aryaan-hegde/PulseOS/README.md

# PulseOS
A smartwatch that can detect, monitor and display your heart rate. Controlled with a custom RP2350-based PCB
