aryaan-hegde/PulseOS/f5d17f86-9e19-4940-80e7-bea705c3136f.png

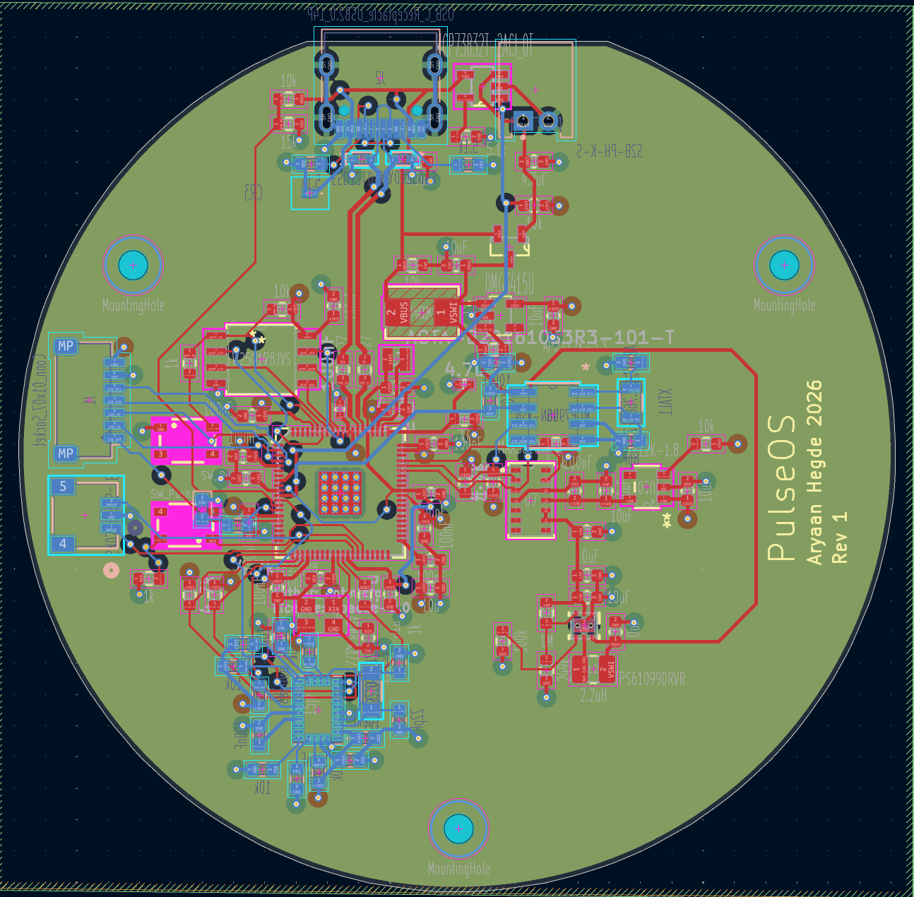
f5d17f86-9e19-4940-80e7-bea705c3136f.png
