aryaan-hegde/PulseOS/PCB/pulse_os/pulse_os.csv

Reference | Qty | Value | DNP | Exclude from BOM | Exclude from Board | Exclude from Simulation | Exclude from Position Files | Footprint | Datasheet
C1,C2,C31,C34,C35,C36,C37,C38 | 8 | 10uF |  |  |  |  | ${EXCLUDE_FROM_POS_FILES} | Capacitor_SMD:C_0603_1608Metric
C3,C6,C27,C28,C29 | 5 | 100nF |  |  |  |  | ${EXCLUDE_FROM_POS_FILES} | Capacitor_SMD:C_0603_1608Metric
C4,C5 | 2 | 8pF |  |  |  |  | ${EXCLUDE_FROM_POS_FILES} | Capacitor_SMD:C_0603_1608Metric
C7,C26 | 2 | 22pF |  |  |  |  | ${EXCLUDE_FROM_POS_FILES} | Capacitor_SMD:C_0603_1608Metric
C8,C11,C13,C14,C15,C16,C17,C18,C19,C20,C21 | 11 | 100n |  |  |  |  | ${EXCLUDE_FROM_POS_FILES} | Capacitor_SMD:C_0603_1608Metric
C9,C10,C12,C22 | 4 | 4.7u |  |  |  |  | ${EXCLUDE_FROM_POS_FILES} | Capacitor_SMD:C_0603_1608Metric
C23 | 1 | 10u |  |  |  |  | ${EXCLUDE_FROM_POS_FILES} | Capacitor_SMD:C_0603_1608Metric
C24,C25 | 2 | 15pF |  |  |  |  | ${EXCLUDE_FROM_POS_FILES} | Capacitor_SMD:C_0603_1608Metric
C30 | 1 | ABS07-32.768KHZ-T |  |  |  |  | ${EXCLUDE_FROM_POS_FILES} | PulseOS Footprints:CAP_ABS07-32.768KHZ-T_ABR | ABS07-32.768KHZ-T
C32,C33 | 2 | 4.7uF |  |  |  |  | ${EXCLUDE_FROM_POS_FILES} | Capacitor_SMD:C_0603_1608Metric
C39 | 1 | 0.1uF |  |  |  |  | ${EXCLUDE_FROM_POS_FILES} | Capacitor_SMD:C_0603_1608Metric
CR1,CR2 | 2 | ESD321DYAR |  |  |  |  | ${EXCLUDE_FROM_POS_FILES} | PulseOS Footprints:SOT5x3_DYA_TEX | https://www.ti.com/lit/gpn/esd321
CR3 | 1 | ESD441DPLR |  |  |  |  | ${EXCLUDE_FROM_POS_FILES} | PulseOS Footprints:X2SON2_DPL_TEX | https://www.ti.com/lit/gpn/esd441
D1 | 1 | CDBW140-G |  |  |  |  | ${EXCLUDE_FROM_POS_FILES} | PulseOS Footprints:CDBB-G
D2 | 1 | LED |  |  |  |  | ${EXCLUDE_FROM_POS_FILES} | LED_SMD:LED_0201_0603Metric
J1 | 1 | Conn_01x07_Socket |  |  |  |  | ${EXCLUDE_FROM_POS_FILES} | Connector_JST:JST_SH_SM07B-SRSS-TB_1x07-1MP_P1.00mm_Horizontal
J2 | 1 | USB_C_Receptacle_USB2.0_14P |  |  |  |  | ${EXCLUDE_FROM_POS_FILES} | Connector_USB:USB_C_Receptacle_HRO_TYPE-C-31-M-12 | https://www.usb.org/sites/default/files/documents/usb_type-c.zip
J3 | 1 | S2B-PH-K-S |  |  |  |  | ${EXCLUDE_FROM_POS_FILES} | PulseOS Footprints:JST_S2B-PH-K-S
J4 | 1 | SM03B-SRSS-TB |  |  |  |  | ${EXCLUDE_FROM_POS_FILES} | PulseOS Footprints:CONN_SM03B-SRSS-TB_JST | SM03B-SRSS-TB
L2 | 1 | 2.2uH |  |  |  |  | ${EXCLUDE_FROM_POS_FILES} | Inductor_SMD:L_1008_2520Metric
L3 | 1 | AOTA-B201610S3R3-101-T |  |  |  |  | ${EXCLUDE_FROM_POS_FILES} | PulseOS Footprints:IND_AOTA-B201610S_2p0x1p6x1p0_ABR | AOTA-B201610S3R3-101-T
Q1 | 1 | DMG3415U |  |  |  |  | ${EXCLUDE_FROM_POS_FILES} | PulseOS Footprints:DMG3415U | https://ngspice.sourceforge.io/docs/ngspice-html-manual/manual.xhtml#cha_MOSFETs
R1,R2,R20 | 3 | 5.1k |  |  |  |  | ${EXCLUDE_FROM_POS_FILES} | Resistor_SMD:R_0603_1608Metric
R5 | 1 | 33 |  |  |  |  | ${EXCLUDE_FROM_POS_FILES} | Resistor_SMD:R_0603_1608Metric
R6,R7,R8,R16,R21,R22,R29,R31,R32,R33,R34,R35,R36,R37,R39 | 15 | 10k |  |  |  |  | ${EXCLUDE_FROM_POS_FILES} | Resistor_SMD:R_0603_1608Metric
R9,R10,R11,R40 | 4 | 1k |  |  |  |  | ${EXCLUDE_FROM_POS_FILES} | Resistor_SMD:R_0603_1608Metric
R17,R25 | 2 | 27 |  |  |  |  | ${EXCLUDE_FROM_POS_FILES} | Resistor_SMD:R_0603_1608Metric
R18,R19,R27,R28,R38 | 5 | 4.7k |  |  |  |  | ${EXCLUDE_FROM_POS_FILES} | Resistor_SMD:R_0603_1608Metric
R23 | 1 | 1M |  |  |  |  | ${EXCLUDE_FROM_POS_FILES} | Resistor_SMD:R_0603_1608Metric
R24 | 1 | 249k |  |  |  |  | ${EXCLUDE_FROM_POS_FILES} | Resistor_SMD:R_0603_1608Metric
R26 | 1 | 100k |  |  |  |  | ${EXCLUDE_FROM_POS_FILES} | Resistor_SMD:R_0603_1608Metric
R30 | 1 | 15k |  |  |  |  | ${EXCLUDE_FROM_POS_FILES} | Resistor_SMD:R_0603_1608Metric
SW1,SW2 | 2 | SW_Push |  |  |  |  | ${EXCLUDE_FROM_POS_FILES} | PulseOS Footprints:434133025816
U1 | 1 | RP2350B |  |  |  |  | ${EXCLUDE_FROM_POS_FILES} | PulseOS Footprints:QFN-80_EP_10x10_Pitch0.4mm | https://datasheets.raspberrypi.com/rp2350/rp2350-datasheet.pdf
U2 | 1 | AP2112K-3.3 |  |  |  |  | ${EXCLUDE_FROM_POS_FILES} | PulseOS Footprints:AP2112K_3_3 | https://www.diodes.com/assets/Datasheets/AP2112.pdf
U4 | 1 | W25Q128JVS |  |  |  |  | ${EXCLUDE_FROM_POS_FILES} | PulseOS Footprints:SOIC_128JVSIQ_WIN | https://www.winbond.com/resource-files/w25q128jv_dtr%20revc%2003272018%20plus.pdf
U5 | 1 | BNO085 |  |  |  |  | ${EXCLUDE_FROM_POS_FILES} | PulseOS Footprints:IC_BNO085
U6 | 1 | MCP7940N-xSN |  |  |  |  | ${EXCLUDE_FROM_POS_FILES} | PulseOS Footprints:SOIC8-N_MC_MCH | http://ww1.microchip.com/downloads/en/DeviceDoc/20005010F.pdf
U7 | 1 | MAX30101EFD+ |  |  |  |  | ${EXCLUDE_FROM_POS_FILES} | PulseOS Footprints:MAX30101 | MAX30101EFD+
U8 | 1 | TPS61099DRVR |  |  |  |  | ${EXCLUDE_FROM_POS_FILES} | PulseOS Footprints:DRV0006A | https://www.ti.com/lit/gpn/tps61099
U9 | 1 | MCP73832T-2ACI_OT |  |  |  |  | ${EXCLUDE_FROM_POS_FILES} | PulseOS Footprints:MCP73832T
U10 | 1 | AP2112K-1.8 |  |  |  |  | ${EXCLUDE_FROM_POS_FILES} | PulseOS Footprints:AP2112K-1.8TRG1_DIO | https://www.diodes.com/assets/Datasheets/AP2112.pdf
X1 | 1 | ABM8-272-T3 |  |  |  |  | ${EXCLUDE_FROM_POS_FILES} | PulseOS Footprints:ABM8-272-T3_ABR | ABM8-272-T3
XTAL1 | 1 | ABS07-32.768KHZ-7-T |  |  |  |  | ${EXCLUDE_FROM_POS_FILES} | PulseOS Footprints:XTAL_ABS07-32.768KHZ-7-T_ABR | ABS07-32.768KHZ-7-T
