aryaan-hegde/PulseOS/3D_files/assembly.stl

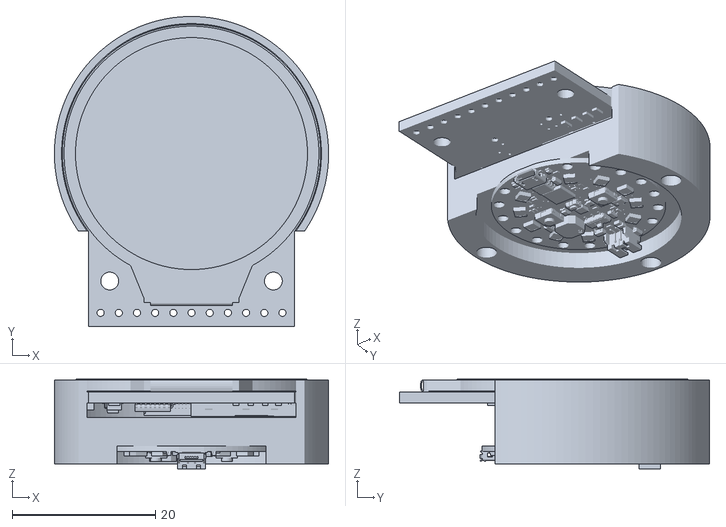
[picture p16: CAD file, 2026-10-20]
3D_files/assembly.stl
38.3 x 43.3 x 12.5
