aryaan-hegde/PulseOS/PCB/pulse_os/3d_models/SOIC8-N_MC_MCH.step

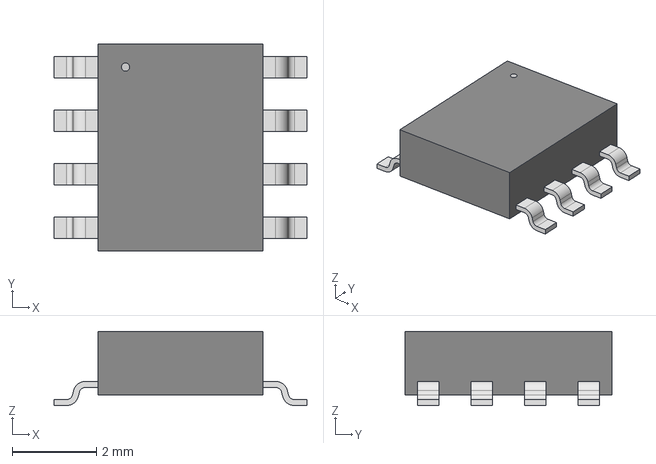
[picture p17: CAD file, 2026-11-12]
PCB/pulse_os/3d_models/SOIC8-N_MC_MCH.step
5.99 x 4.90 x 1.75 mm
