aryaan-hegde/PulseOS/PCB/pulse_os/3d_models/ESD441DPYR.stp

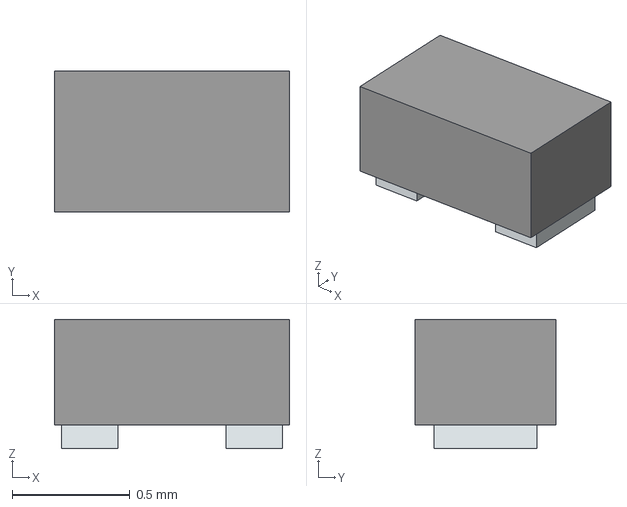
[picture p18: CAD file, 2026-11-12]
PCB/pulse_os/3d_models/ESD441DPYR.stp
1.00 x 0.6 x 0.55 mm
Pins
