aryaan-hegde/PulseOS/PCB/pulse_os/3d_models/ABM8-272-T3_ABR.step

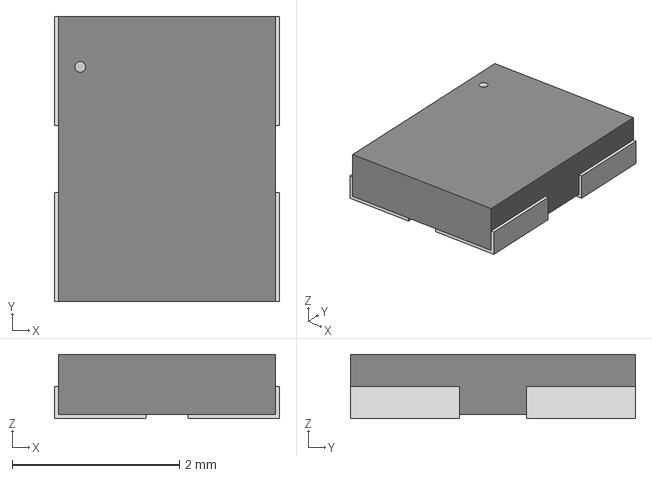
[picture p19: CAD file, 2026-11-12]
PCB/pulse_os/3d_models/ABM8-272-T3_ABR.step
2.69 x 3.40 x 0.765 mm
