aryaan-hegde/PulseOS/PCB/pulse_os/3d_models/SOT-23-5_MC_MCH.step

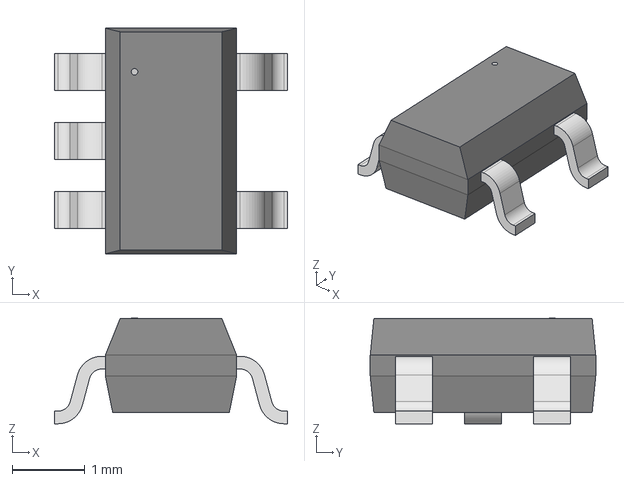
[picture p20: CAD file, 2026-11-12]
PCB/pulse_os/3d_models/SOT-23-5_MC_MCH.step
3.20 x 3.10 x 1.45 mm
