aryaan-hegde/PulseOS/PCB/pulse_os/3d_models/IND_AOTA-B201610S_2p0x1p6x1p0_ABR.stl

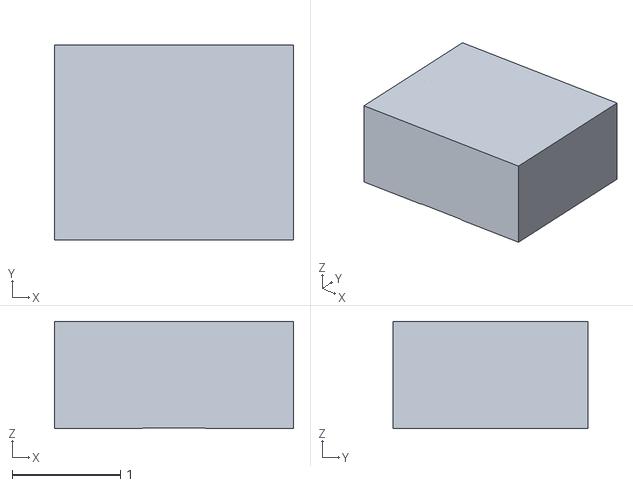
[picture p21: CAD file, 2026-11-12]
PCB/pulse_os/3d_models/IND_AOTA-B201610S_2p0x1p6x1p0_ABR.stl
2.21 x 1.80 x 0.993
