aryaan-hegde/PulseOS/PCB/pulse_os/3d_models/XTAL_ABS07-32_768KHZ-7-T_ABR.stl

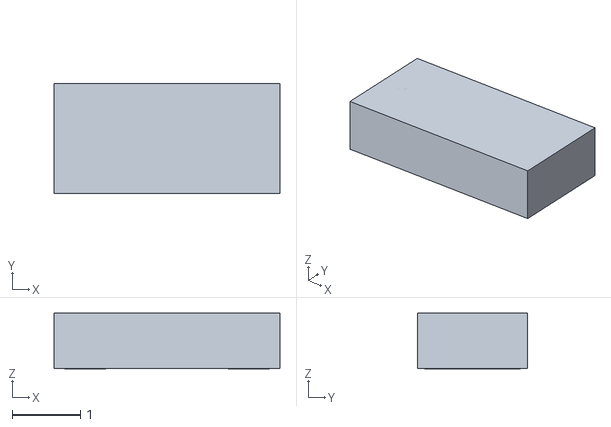
[picture p22: CAD file, 2026-11-12]
PCB/pulse_os/3d_models/XTAL_ABS07-32_768KHZ-7-T_ABR.stl
3.30 x 1.60 x 0.815
