aryaan-hegde/PulseOS/PCB/pulse_os/3d_models/SOIC_128JVSIQ_WIN.stl

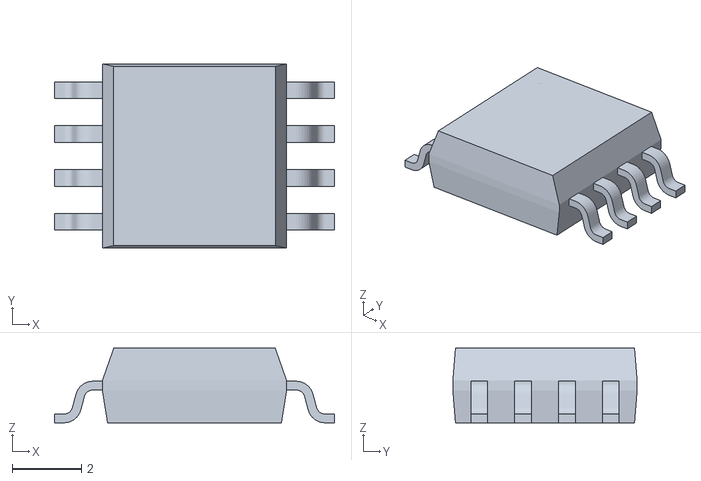
[picture p23: CAD file, 2026-11-12]
PCB/pulse_os/3d_models/SOIC_128JVSIQ_WIN.stl
8.10 x 5.33 x 2.16
