aryaan-hegde/PulseOS/PCB/pulse_os/3d_models/TPS61099DRVR.STEP

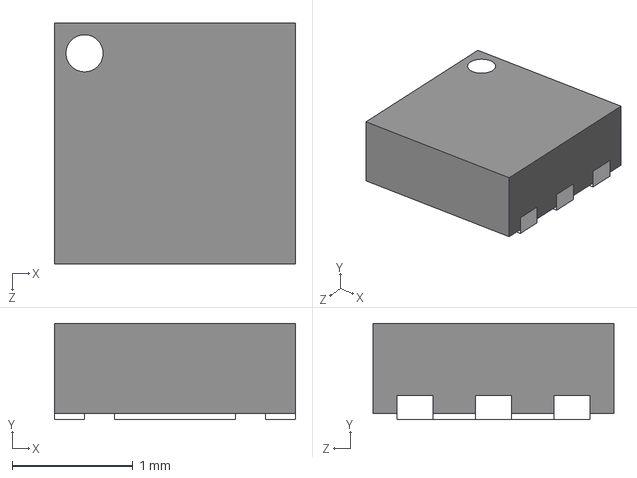
[picture p24: CAD file, 2026-11-12]
PCB/pulse_os/3d_models/TPS61099DRVR.STEP
2.00 x 0.8 x 2.00 mm
