aryaan-hegde/PulseOS/PCB/pulse_os/pulse_os.kicad_pcb

## KiCad design PCB/pulse_os/pulse_os.kicad_pcb (2026-11-12)

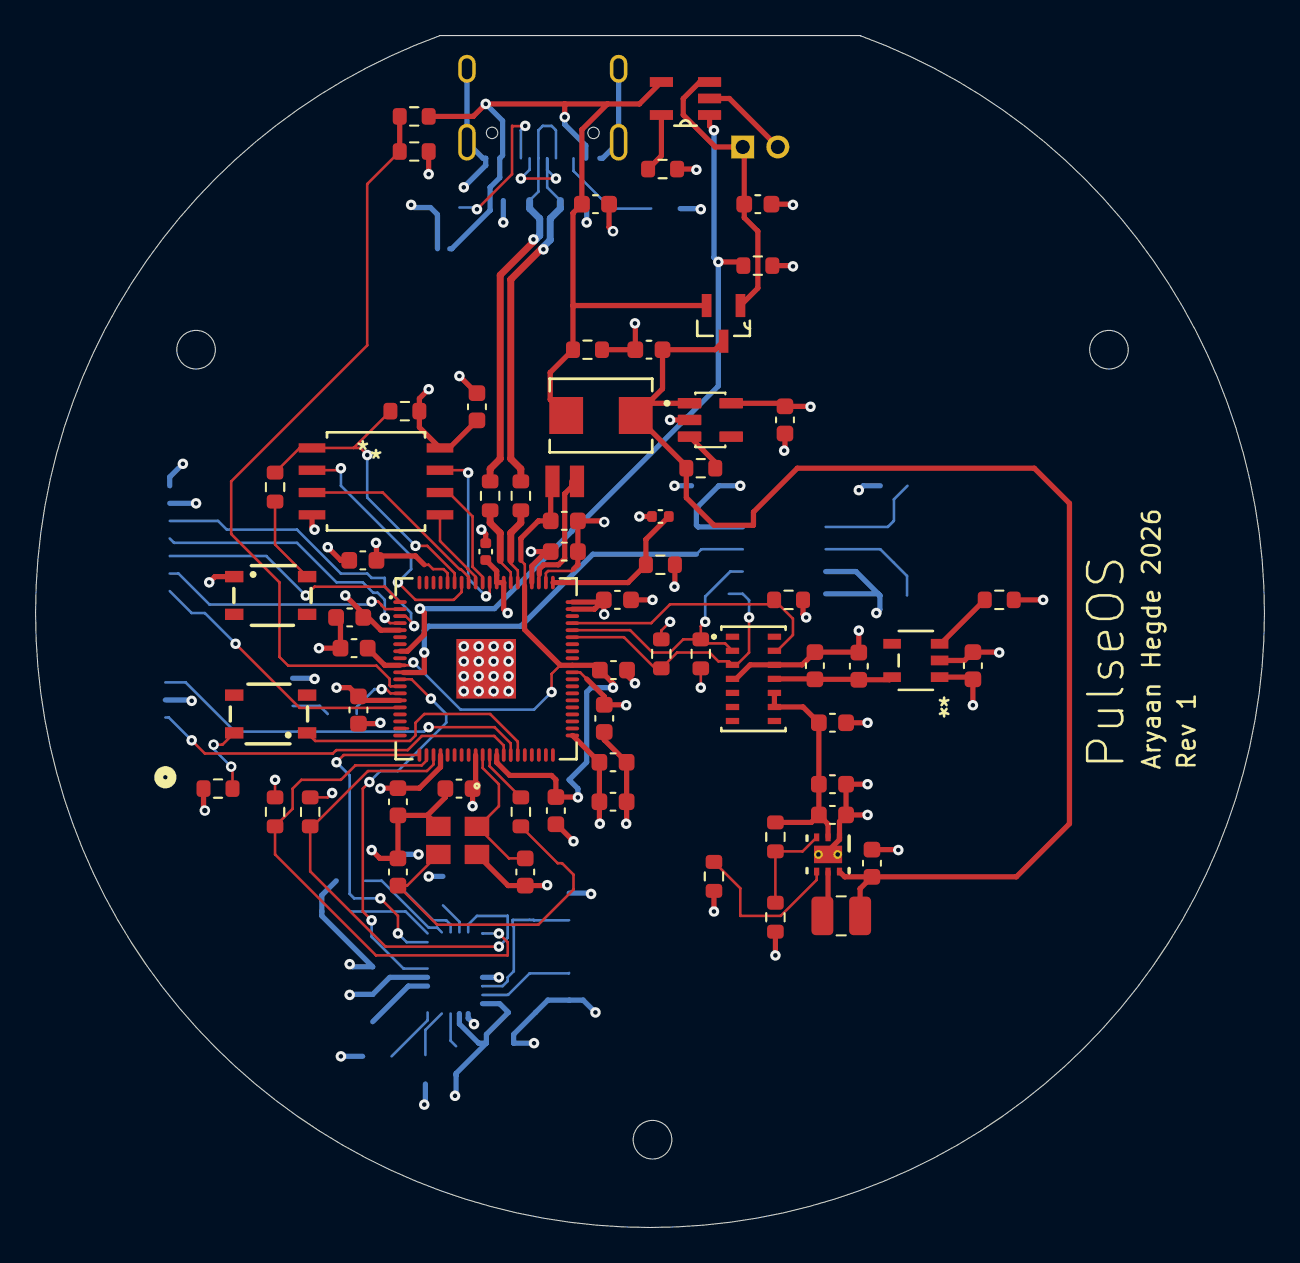
[picture p25: board pulse_os.kicad_pcb from above]

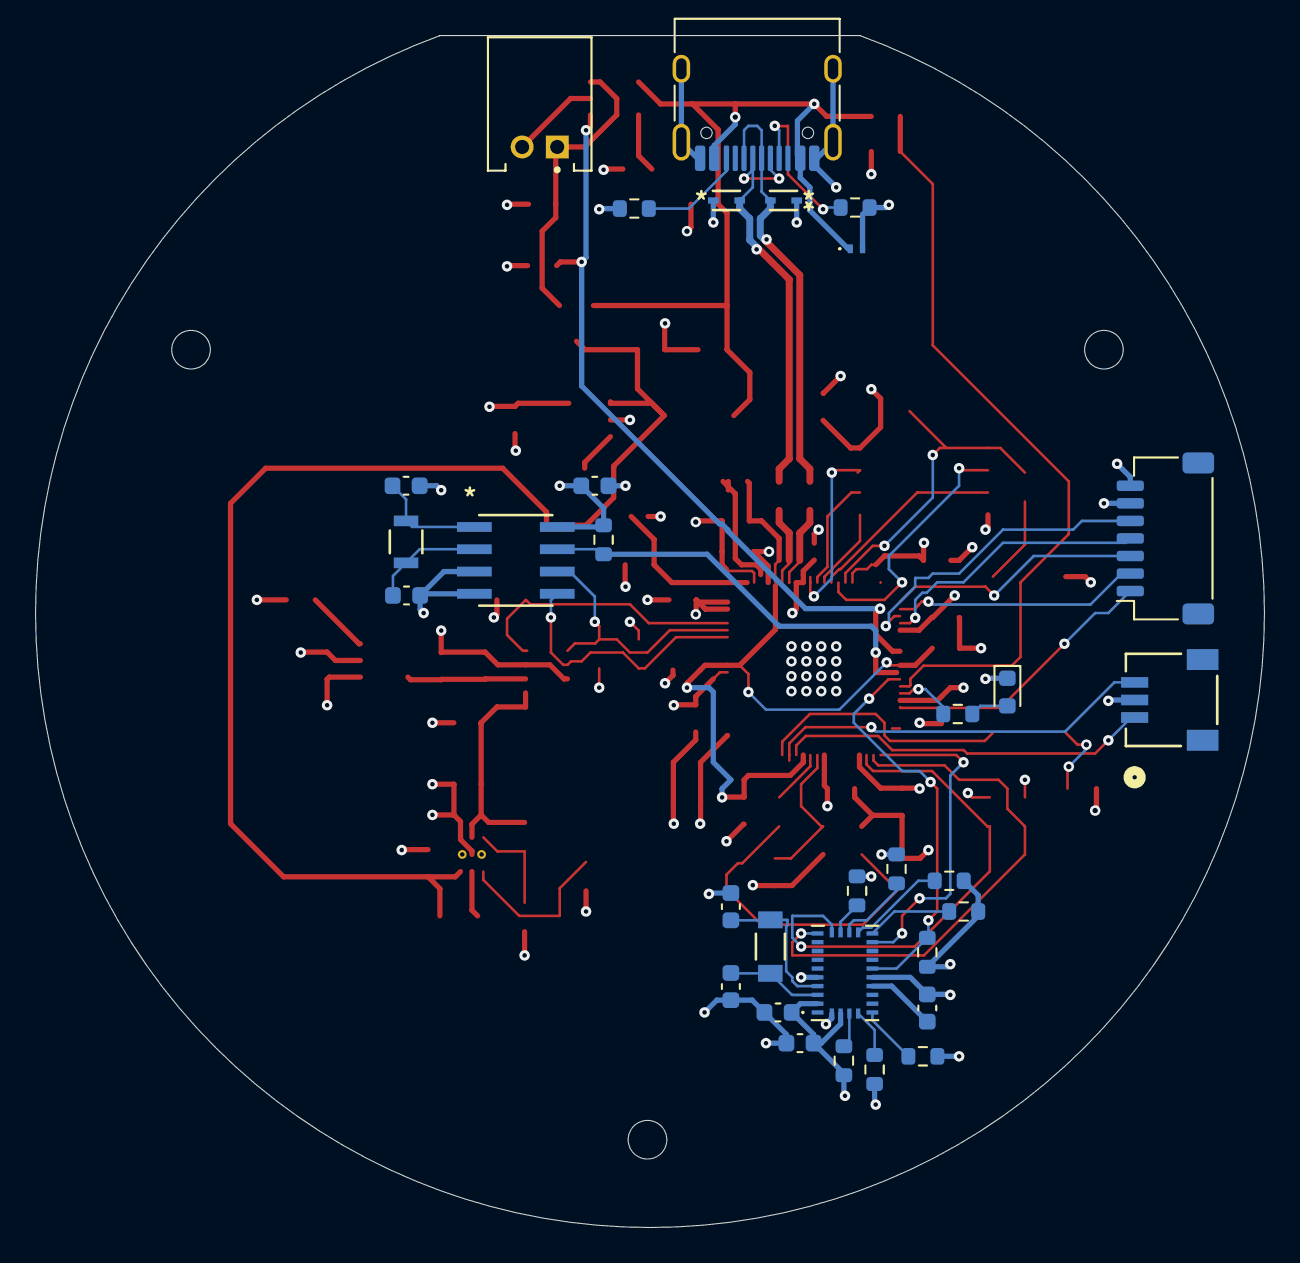
[picture p26: board pulse_os.kicad_pcb from below]

Board: 4 copper layers, 70.0 x 67.9 mm, 101 parts (32 on the bottom side), 65 nets.

Parts:
C1, C2, C31, C34, C35, C36, C37, C38: 10uF; C_0603_1608Metric
C3, C6, C8, C11, C13, C14, C15, C17, C18, C19, C20, C21, C27, C28, C29, C39: 100nF; C_0603_1608Metric
C4, C5: 8pF; C_0603_1608Metric
C7, C26: 22pF; C_0603_1608Metric
C9: 4.7u; C_0402_1005Metric
C10, C12, C22: 4.7u; C_0603_1608Metric
C16: 100nF; C_0402_1005Metric
C23: 10u; C_0603_1608Metric
C24, C25: 15pF; C_0603_1608Metric
C30: ABS07-32.768KHZ-T; CAP_ABS07-32.768KHZ-T_ABR
C32, C33: 4.7uF; C_0603_1608Metric
CR1, CR2: ESD321DYAR; SOT5x3_DYA_TEX
CR3: ESD441DPLR; ESD441DPYR
D1: CDBW140-G; CDBB-G
D2: LED; LED_0603_1608Metric
H1, H2, H3: MountingHole; MountingHole_2.2mm_M2
J1: Conn_01x07_Socket; JST_SH_SM07B-SRSS-TB_1x07-1MP_P1.00mm_Horizontal
J2: USB_C_Receptacle_USB2.0_14P; USB_C_Receptacle_HRO_TYPE-C-31-M-12
J3: S2B-PH-K-S; JST_S2B-PH-K-S
J4: SM03B-SRSS-TB; CONN_SM03B-SRSS-TB_JST
L2: 2.2uH; L_1008_2520Metric
L3: AOTA-B201610S3R3-101-T; IND_AOTA-B201610S_2p0x1p6x1p0_ABR
Q1: DMG3415U
R1, R2, R20: 5.1k; R_0603_1608Metric
R5: 33; R_0603_1608Metric
R6, R7, R8, R16, R21, R22, R29, R31, R32, R33, R34, R35, R36, R37, R39: 10k; R_0603_1608Metric
R9, R10, R11, R40: 1k; R_0603_1608Metric
R17, R25: 27; R_0603_1608Metric
R18, R19, R27, R28, R38: 4.7k; R_0603_1608Metric
R23: 1M; R_0603_1608Metric
R24: 249k; R_0603_1608Metric
R26: 100k; R_0603_1608Metric
R30: 15k; R_0603_1608Metric
SW1, SW2: SW_Push; 434133025816
U1: RP2350B; QFN-80_EP_10x10_Pitch0.4mm
U2: AP2112K-3.3; AP2112K_3_3
U4: W25Q128JVS; SOIC_128JVSIQ_WIN
U5: BNO085; IC_BNO085
U6: MCP7940N-xSN; SOIC8-N_MC_MCH
U7: MAX30101EFD+; MAX30101
U8: TPS61099DRVR; DRV0006A
U9: MCP73832T-2ACI_OT; MCP73832T
U10: AP2112K-1.8; AP2112K-1.8TRG1_DIO
X1: ABM8-272-T3; ABM8-272-T3_ABR
XTAL1: ABS07-32.768KHZ-7-T; XTAL_ABS07-32.768KHZ-7-T_ABR

Connections:
+1V1: C8.1, C10.1, C11.1, C22.1, L3.1, U1.10 (DVDD), U1.32 (DVDD), U1.51 (DVDD), U1.65 (VREG_FB)
+1V8: C38.1, C39.1, U7.11 (VDD), U10.5 (VOUT)
+3V3: C2.1, C3.1, C6.1, C12.1, C13.1, C14.1, C15.1, C16.1, C17.1, C18.1, C19.1, C20.1, C21.1, C23.1, C28.1, C29.1, C31.1, J1.7, R5.2, R7.1, R16.1, R18.2, R19.2, R21.2, R22.1, R27.2, R28.2, R31.2, R33.2, R34.2, R37.2, R38.2, R39.2, U1.5 (IOVDD), U1.15 (IOVDD), U1.24 (IOVDD), U1.29 (IOVDD), U1.41 (IOVDD), U1.50 (IOVDD), U1.59 (ADC_AVDD), U1.60 (IOVDD), U1.64 (VREG_VIN), U1.68 (USB_OTP_VDD), U1.69 (QSPI_IOVDD), U1.76 (IOVDD), U2.5 (VOUT), U4.8 (VCC), U5.3 (VDD), U5.28 (VDDIO), U6.8 (VCC), U10.1 (VIN)
+5V: C35.1, C36.1, C37.1, R23.2, U7.9 (VLED+), U7.10 (VLED+), U8.2 (VOUT)
/MCU/INDICATOR_LED: R40.2, U1.14 (GPIO15)
/MCU/QSPI_SCLK: U1.71 (QSPI_SCLK), U4.6 (CLK)
/MCU/QSPI_SD0: U1.72 (QSPI_SD0), U4.5 (DI/IO_{0})
/MCU/QSPI_SD1: U1.74 (QSPI_SD1), U4.2 (DO/IO_{1})
/MCU/QSPI_SD2: U1.73 (QSPI_SD2), U4.3 (~WP/IO_{2})
/MCU/QSPI_SD3: U1.70 (QSPI_SD3), U4.7 (~HOLD/~RESET/IO_{3})
/MCU/QSPI_SS: R7.2, R9.1, U1.75 (~QSPI_SS), U4.1 (~CS)
/MCU/RUN: SW2.1, U1.35 (RUN)
/MCU/SWCLK: J4.1, U1.33 (SWCLK)
/MCU/SWDIO: J4.3, U1.34 (SWDIO)
/MCU/USB_ON: R29.2, R30.1, U1.13 (GPIO14)
/MCU/XIN: C24.1, U1.30 (XIN), X1.1
/MCU/XOUT: R10.2, U1.31 (XOUT)
/Peripherals/BOOTN: R34.1, U5.4 (~BOOT)
/Peripherals/ENV_SCL: R37.1, U5.15 (ENV_SCL)
/Peripherals/ENV_SDA: R39.1, U5.16 (ENV_SDA)
/Peripherals/H_CSN: R31.1, U5.18 (~H_CS)
/Peripherals/PS0: R32.1, U5.6 (PS0/WAKE)
/Peripherals/PS1: R35.1, U5.5 (PS1)
/Peripherals/SA0: R36.1, U5.17 (SA0/H_MOSI)
/Power/D+: CR1.2 (I/O), J2.A6 (D+), J2.B6 (D+), R25.1
/Power/D-: CR2.2 (I/O), J2.A7 (D-), J2.B7 (D-), R17.1
GND: C1.2, C2.2, C3.2, C4.2, C5.2, C6.2, C7.2, C8.2, C9.2, C10.2, C11.2, C12.2, C13.2, C14.2, C15.2, C16.2, C17.2, C18.2, C19.2, C20.2, C21.2, C22.2, C23.2, C24.2, C25.2, C26.2, C27.2, C28.2, C29.2, C31.2, C32.2, C33.2, C34.2, C35.2, C36.2, C37.2, C38.2, C39.2, CR1.1 (GND), CR2.1 (GND), CR3.2 (GND), D2.1 (K), J1.6, J2.A1 (GND), J2.A12 (GND), J2.B1 (GND), J2.B12 (GND), J2.SH (SHIELD), J3.2, J4.2, R1.2, R2.2, R6.2, R11.1, R20.2, R24.1, R26.1, R30.2, R32.2, R35.2, R36.2, SW1.1, U1.62 (VREG_PGND), U1.81 (GND), U2.2 (GND), U4.4 (GND), U5.2 (GND), U5.10 (CLKSEL0), U5.25 (GNDIO), U6.3 (VBAT), U6.4 (VSS), U7.4 (PGND), U7.12 (GND), U8.1 (GND), U8.7 (PAD), U9.2 (VSS), U10.2 (GND), X1.2, X1.4
I2C_BUS0_SCL: R28.1, U1.56 (GPIO45/ADC5), U6.6 (SCL), U7.2 (SCL)
I2C_BUS0_SDA: R27.1, U1.55 (GPIO44/ADC4), U6.5 (SDA), U7.3 (SDA)
I2C_BUS1_SCL: R19.1, U1.23 (GPIO23), U5.19 (H_SCL/SCK/RX)
I2C_BUS1_SDA: R18.1, U1.22 (GPIO22), U5.20 (H_SDA/H_MISO/TX)
IMU_INTN: U1.21 (GPIO21), U5.14 (~H_INT)
IMU_RST: R33.1, U1.12 (GPIO13), U5.11 (~RST)
LCD_CS: J1.2, U1.2 (GPIO5)
LCD_DC: J1.3, U1.1 (GPIO4)
LCD_RST: J1.1, U1.16 (GPIO16)
LCD_SCL: J1.5, U1.3 (GPIO6)
LCD_SDA: J1.4, U1.4 (GPIO7)
MAX_INTN: R38.1, U1.57 (GPIO46/ADC6), U7.13 (*INT)
MFP: R22.2, U1.11 (GPIO12), U6.7 (MFP)
unnamed: C25.1, R10.1, X1.3
unnamed: D2.2 (A), R40.1
unnamed: J2.A5 (CC1), R1.1
unnamed: J2.B5 (CC2), R2.1
unnamed: R9.2, SW1.2
unnamed: R11.2, SW2.2
unnamed: C9.1, R5.1, U1.61 (VREG_AVDD)
unnamed: L3.2, U1.63 (VREG_LX)
unnamed: R8.2, U2.3 (EN)
unnamed: C27.1, U5.9 (CAP)
unnamed: C26.1, C30.1, U5.27 (XIN32)
unnamed: C7.1, C30.2, U5.26 (XOUT32/CLKSEL1)
unnamed: C4.1, U6.1 (X1), XTAL1.1
unnamed: C5.1, U6.2 (X2), XTAL1.2
unnamed: R26.2, U8.4 (EN)
unnamed: R23.1, R24.2, U8.3 (FB)
unnamed: L2.1, U8.5 (SW)
unnamed: R20.1, U9.5 (PROG)
unnamed: R16.2, U10.3 (EN)
STAT: R21.1, U1.8 (GPIO10), U9.1 (STAT)
USB_D+: R25.2, U1.67 (USB_DP)
USB_D-: R17.2, U1.66 (USB_DM)
VBAT: C33.1, J3.1, Q1.1 (D), U9.3 (VBAT)
VBUS: C32.1, CR3.1 (I/O), D1.2 (A), J2.A4 (VBUS), J2.A9 (VBUS), J2.B4 (VBUS), J2.B9 (VBUS), Q1.2 (G), R6.1, R29.1, U9.4 (VDD)
VSWI: C1.1, C34.1, D1.1 (K), L2.2, Q1.3 (S), R8.1, U2.1 (VIN), U8.6 (VIN)
