aryaan-hegde/PulseOS/(commit log)

2026-10-20 PCB files
2026-10-20 Schematics hierarchical sheets
2026-10-21 MCU schematics + USB power complete
2026-10-21 PCB edit
2026-10-22 MCU interconnects to LCD in PCB
2026-10-22 IMU added
2026-10-23 initial work on IMU
2026-10-23 finished IMU
2026-10-25 Schematics ready for review
2026-10-25 Removed junk schematic file
2026-10-29 inital IMU code
2026-11-02 schematic review
2026-11-02 Added more schematic review stuff and finalized switchover mechanism
2026-11-03 Power schematics reviewed
2026-11-03 Power + MCU schematics reviewed
2026-11-03 Schematics reviewed
2026-11-04 Final schematics
2026-11-04 Pin numbers updated
2026-11-04 Added proton board schematic
2026-11-08 PCB updated
2026-11-08 Enhance smartwatch description in README
    Updated the description to include real-time display and daily step calculation features, and added information about battery consumption reduction during idle mode.
